ozanakturk/Dolu-Kapasitoru-Ters-Bagla/arduino_codes_050123/farewell_code/LCD connections.jpg

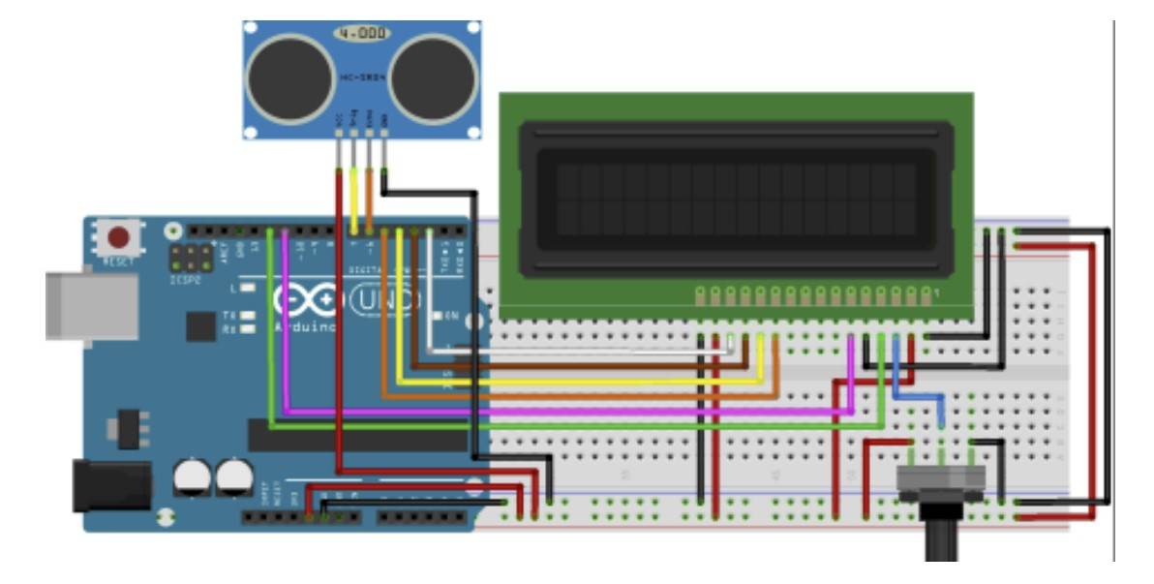
arduino_codes_050123/farewell_code/LCD connections.jpg
