ozanakturk/Dolu-Kapasitoru-Ters-Bagla/README.md

# EE463 Project Github Repo of Dolu Kapasitörü Ters Tut

Ozan Aktürk 2303923

İsa Ersöz 237498

Selin Ezgi Özcan 2375475

Original Project Repo: https://github.com/odtu/ee463/tree/master/Term%20Project
