ozanakturk/Dolu-Kapasitoru-Ters-Bagla/useful links.txt

What is a DC Motor: https://www.youtube.com/watch?v=LAtPHANEfQo

Seperately excited vs. Shunt excited: https://www.youtube.com/watch?v=m2h08euXoDA&list=PLPpCFgQP7QKHUOFYvZhQ6ra5XrU3dN2dD&index=28

Four Quadrant Control with Simulink: https://www.youtube.com/watch?v=LVEipkjerWo

Motor Driver IC info: https://www.youtube.com/watch?v=PVyAcgYkzDs

https://www.youtube.com/watch?v=ygrsIqWOh3Y

https://www.amazon.com/180VDC-motor-controller-output-switch/dp/B0716R6RZQ

https://www.quora.com/How-can-I-convert-220-AC-to-180-DC

https://qr.ae/pvdHLs

Hall sensor 3144  test: https://www.youtube.com/watch?v=pIflB4FQpNE

After presentation:
RPM Counter sensor: https://www.youtube.com/watch?v=XNoN2xGo1F0

Current Sensing with Hall Effect Sensor: https://www.youtube.com/watch?v=p1pQGql65LE
Forget the above link, ACS724 is what you are looking for: https://www.n11.com/urun/acs724-50a-hall-akim-sensor-modulu-14737511?magaza=myrobotech
ACS724 test: https://www.youtube.com/watch?v=ZtrgBSlXcsE

Bootstrap Component Selection Guide by TI: https://www.ti.com/lit/an/slua887/slua887.pdf?ts=1672139985716&ref_url=https%253A%252F%252Fwww.google.com%252F
