ozanakturk/Dolu-Kapasitoru-Ters-Bagla/Final Report/fig/cct.jpg

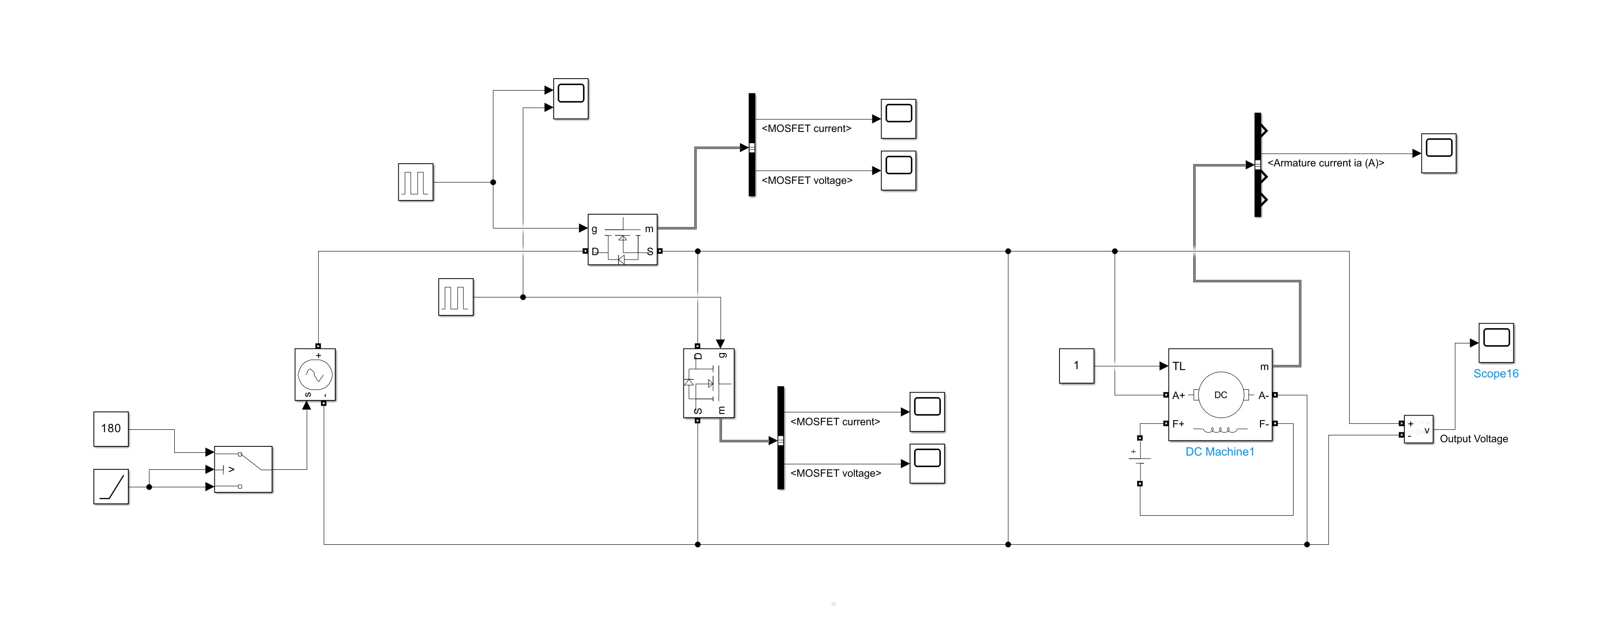
Final Report/fig/cct.jpg
