ozanakturk/Dolu-Kapasitoru-Ters-Bagla/Final Report/fig/diodevolt_rload.jpg

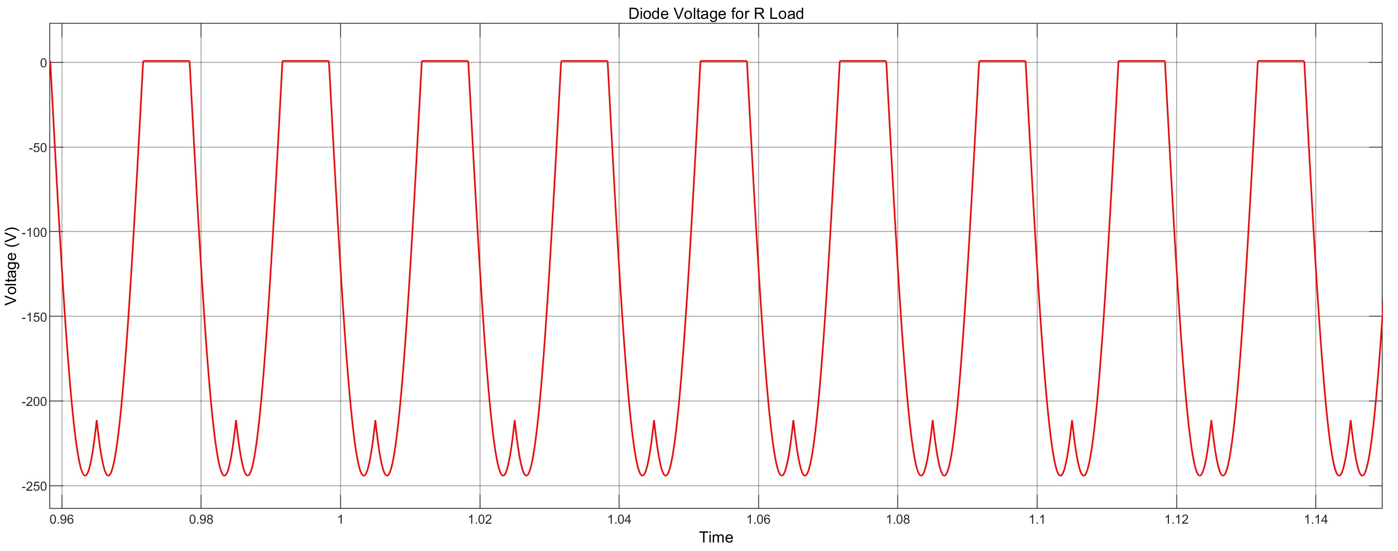
Final Report/fig/diodevolt_rload.jpg
