ozanakturk/Dolu-Kapasitoru-Ters-Bagla/Final Report/fig/diodevoltage.jpg

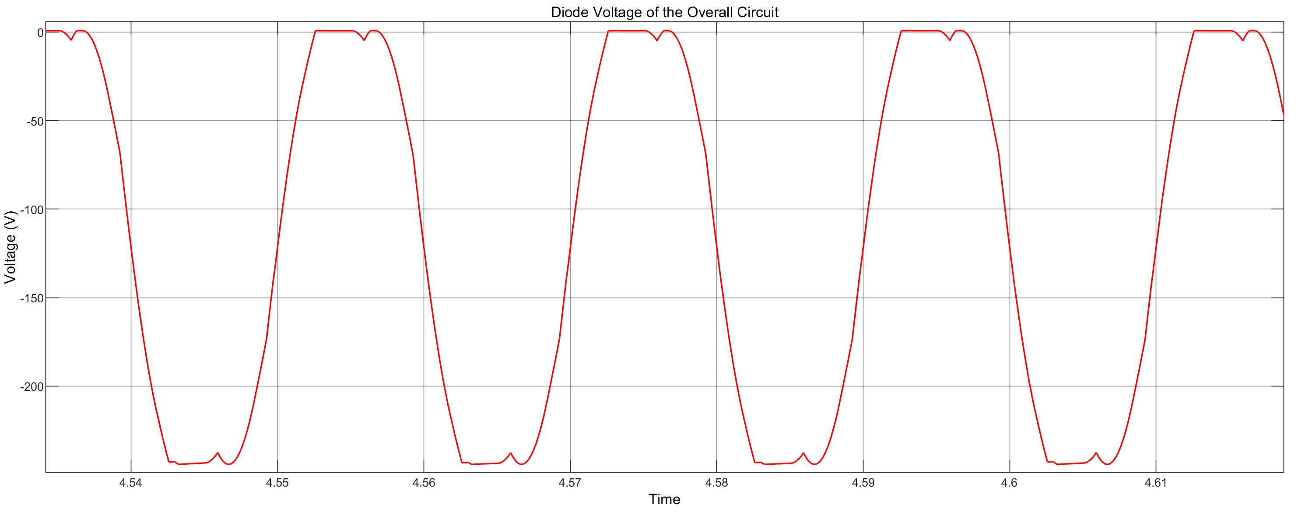
Final Report/fig/diodevoltage.jpg
