ozanakturk/Dolu-Kapasitoru-Ters-Bagla/Final Report/fig/gatesignals.jpg

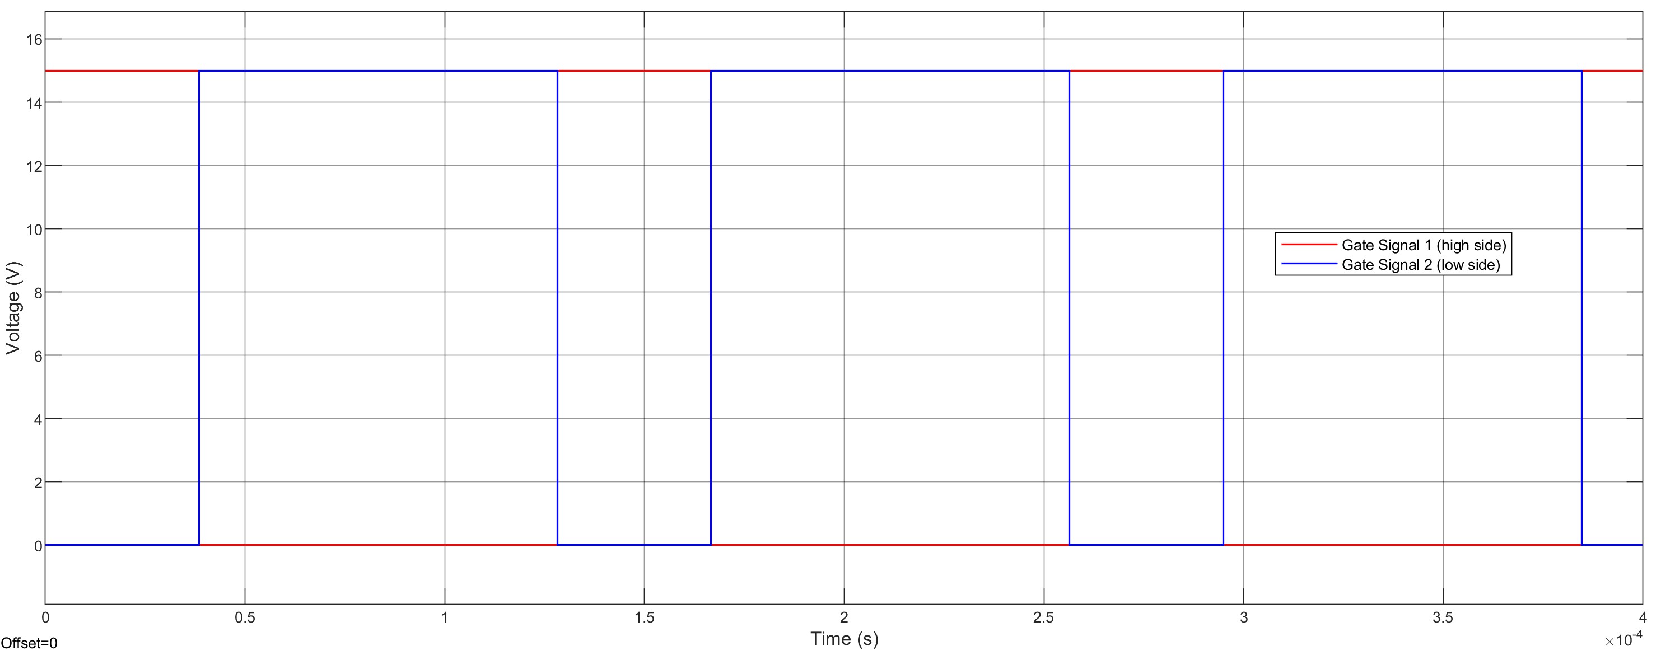
Final Report/fig/gatesignals.jpg
