ozanakturk/Dolu-Kapasitoru-Ters-Bagla/Final Report/fig/hsgate1.jpg

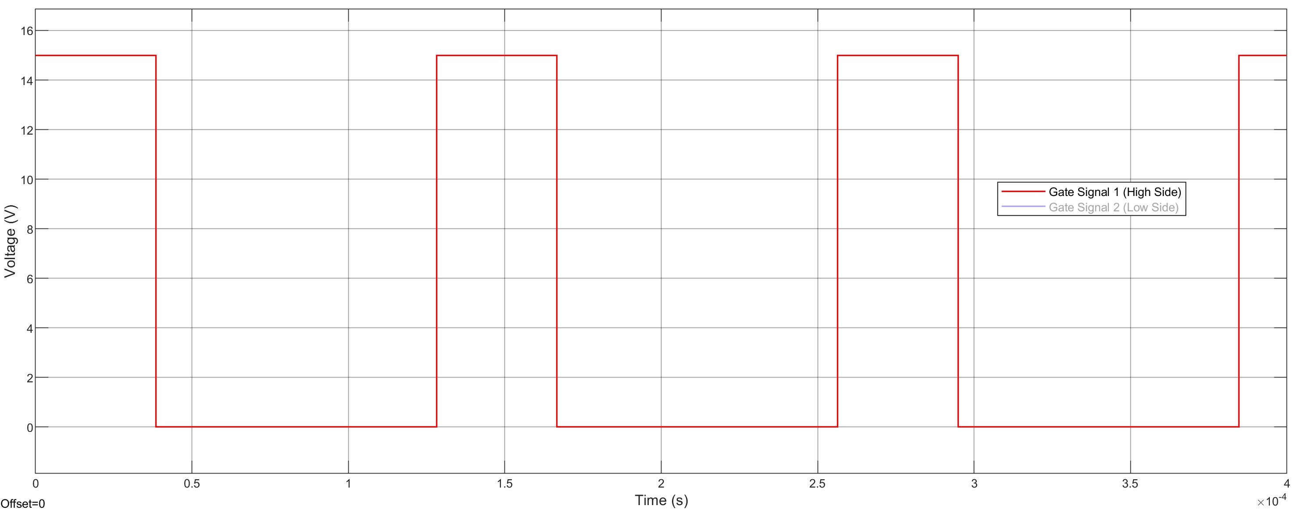
Final Report/fig/hsgate1.jpg
