ozanakturk/Dolu-Kapasitoru-Ters-Bagla/Final Report/fig/lsgate1.jpg

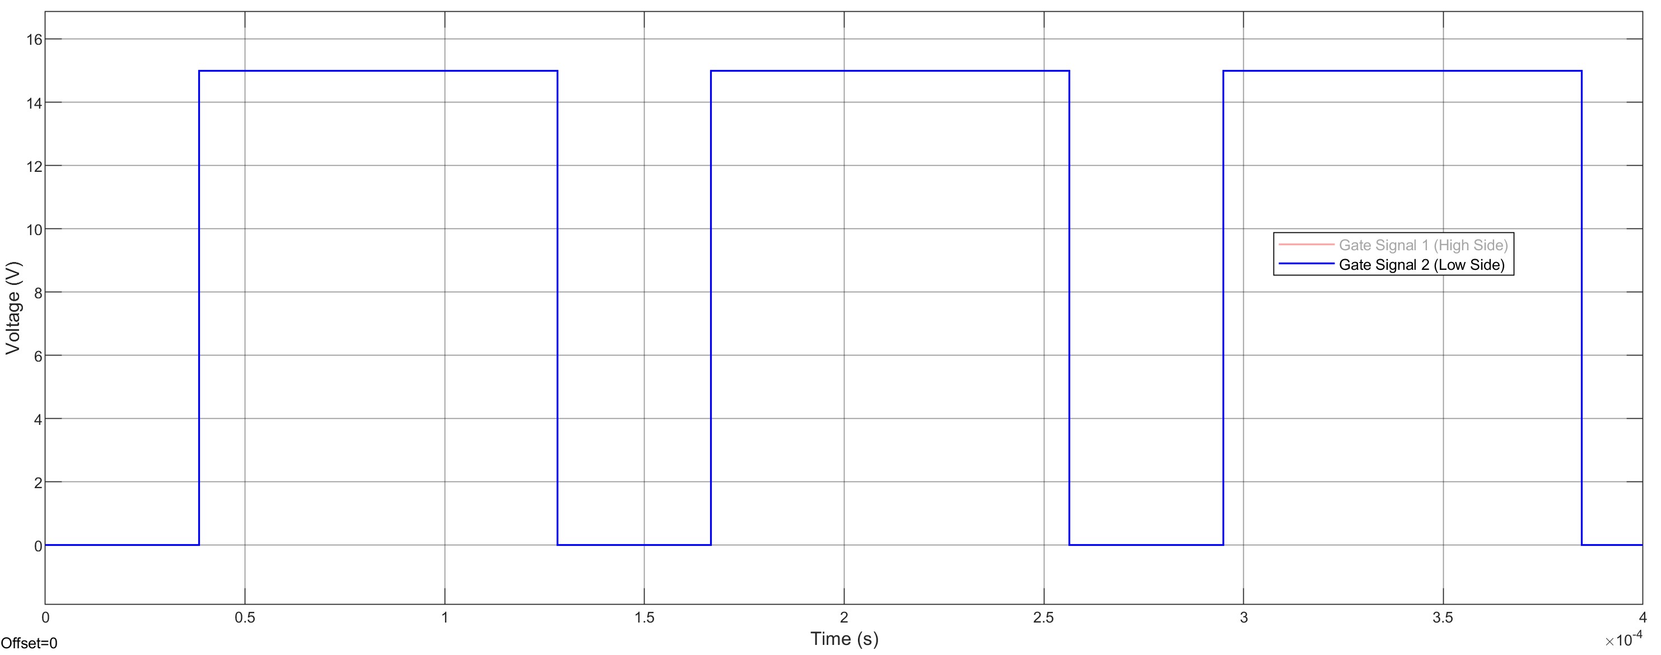
Final Report/fig/lsgate1.jpg
