ozanakturk/Dolu-Kapasitoru-Ters-Bagla/Final Report/fig/rect.jpg

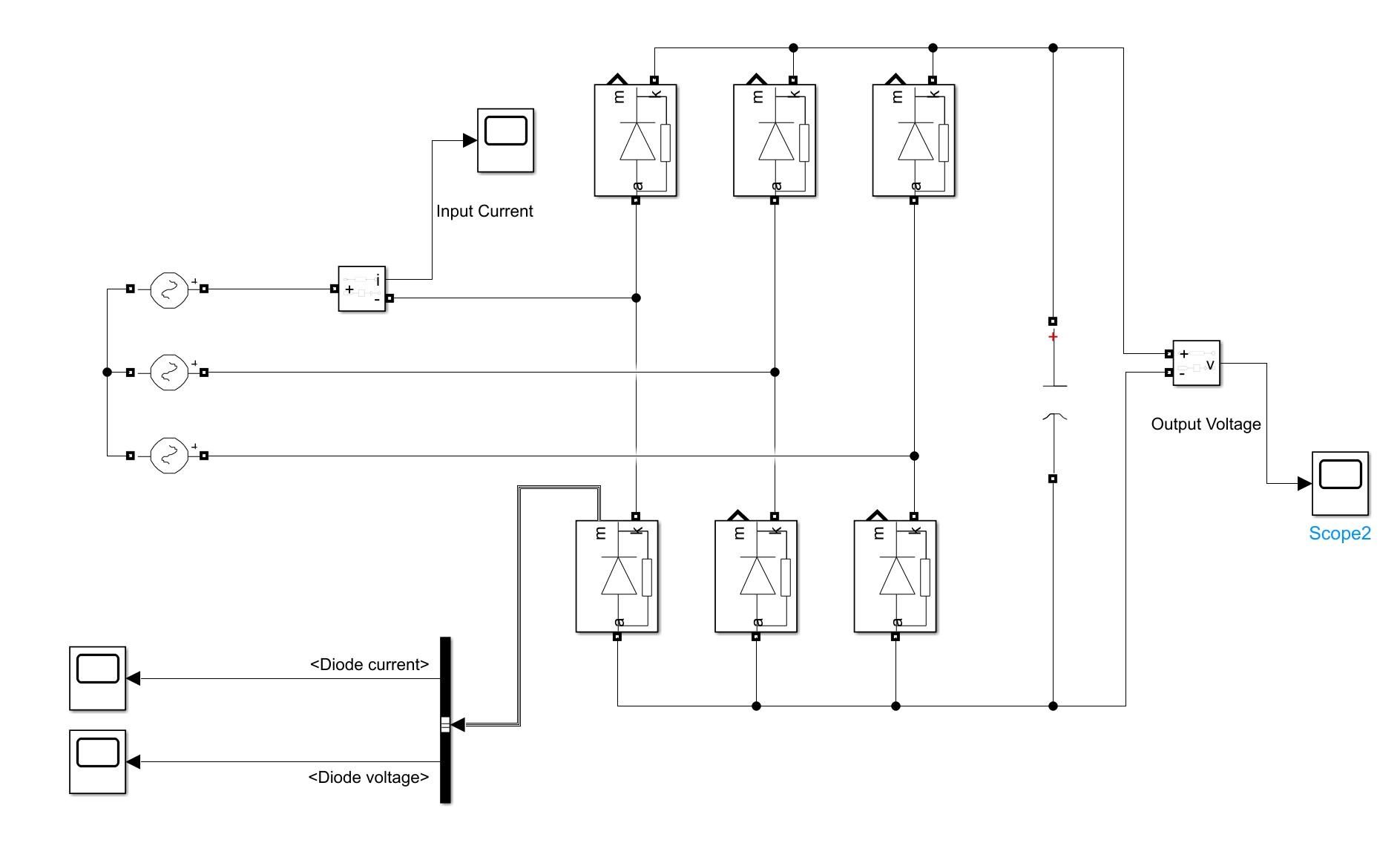
Final Report/fig/rect.jpg
