ozanakturk/Dolu-Kapasitoru-Ters-Bagla/Final Report/fig/rload_rectifier_output.jpg

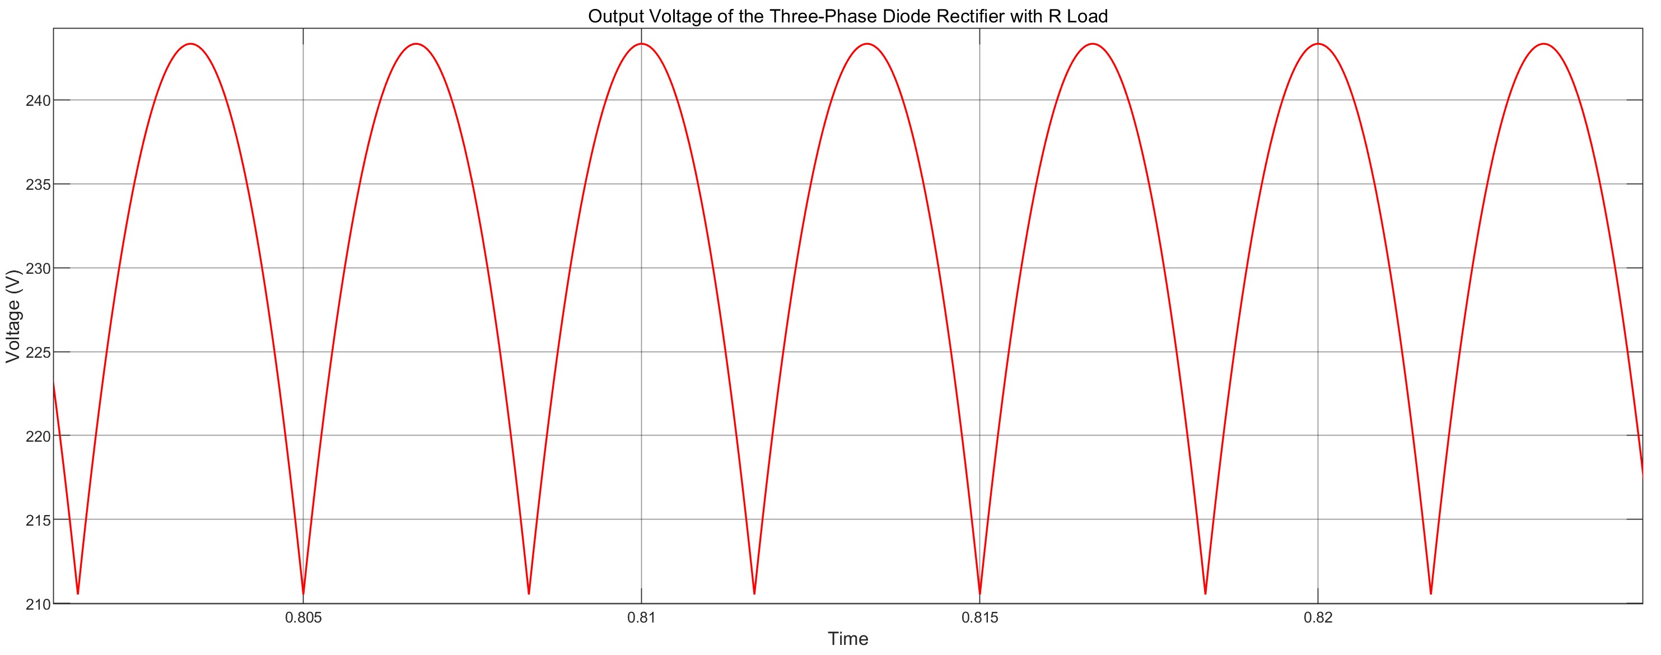
Final Report/fig/rload_rectifier_output.jpg
