ozanakturk/Dolu-Kapasitoru-Ters-Bagla/Final Report/fig/ssdiodecurr.jpg

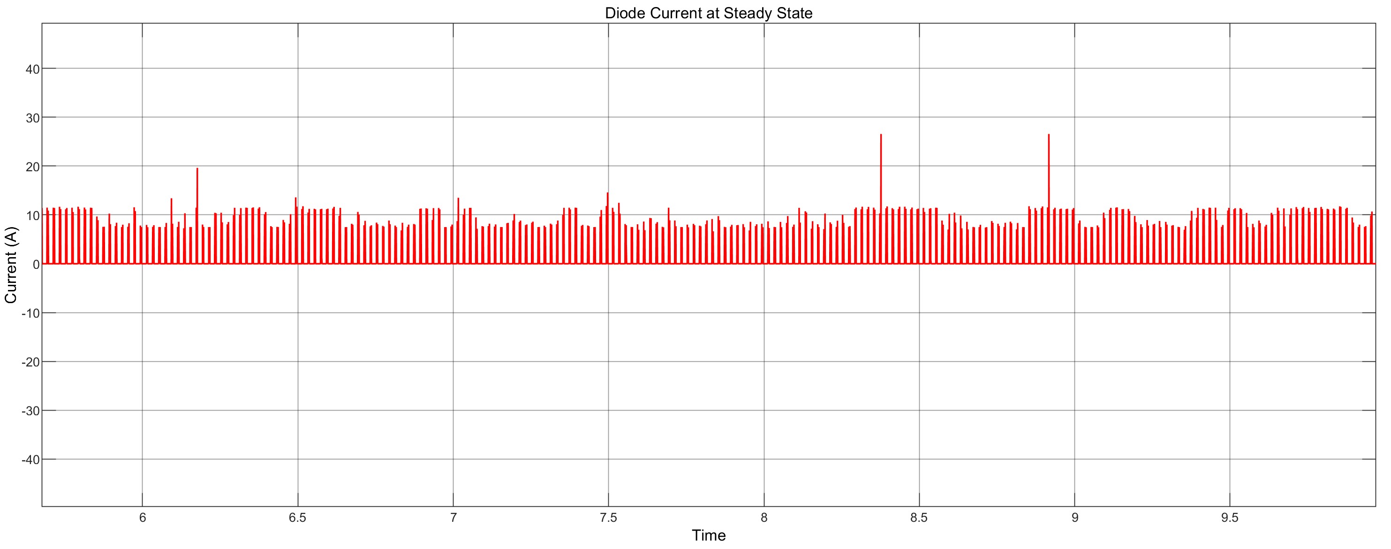
Final Report/fig/ssdiodecurr.jpg
