ozanakturk/Dolu-Kapasitoru-Ters-Bagla/Final Report/fig/ssoutputcurr.jpg

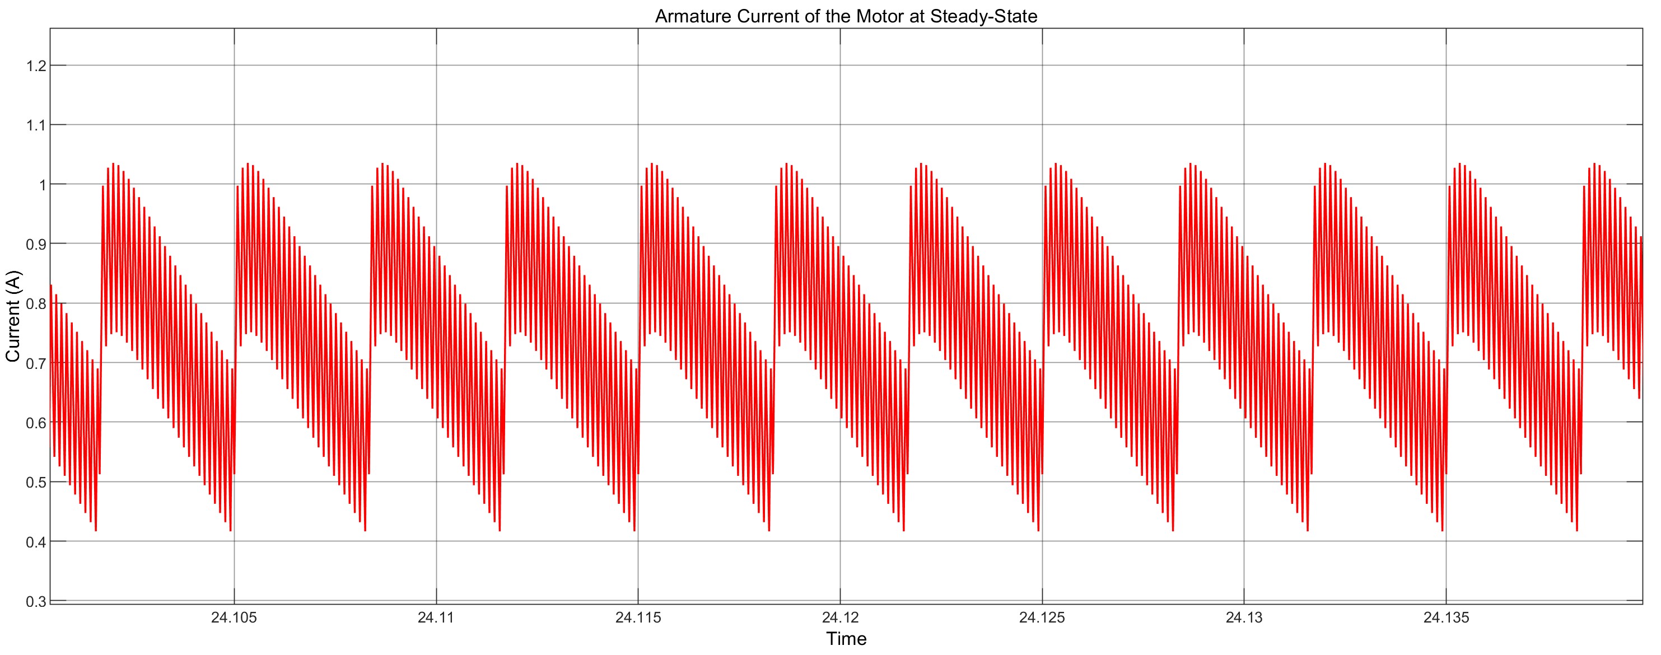
Final Report/fig/ssoutputcurr.jpg
