ozanakturk/Dolu-Kapasitoru-Ters-Bagla/Final Report/fig/ssoutputvolt.jpg

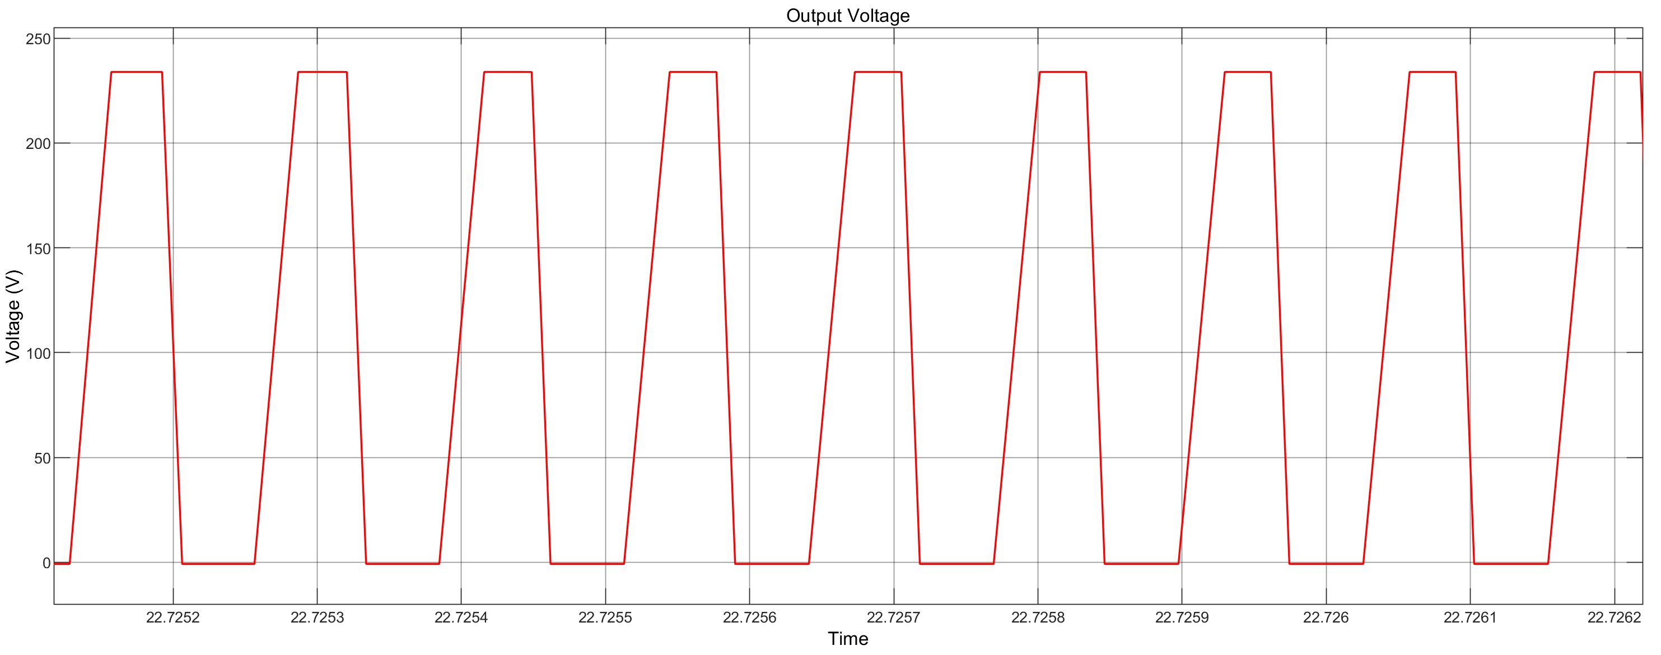
Final Report/fig/ssoutputvolt.jpg
