ozanakturk/Dolu-Kapasitoru-Ters-Bagla/Final Report/fig/together_iout_wo_softstart.jpg

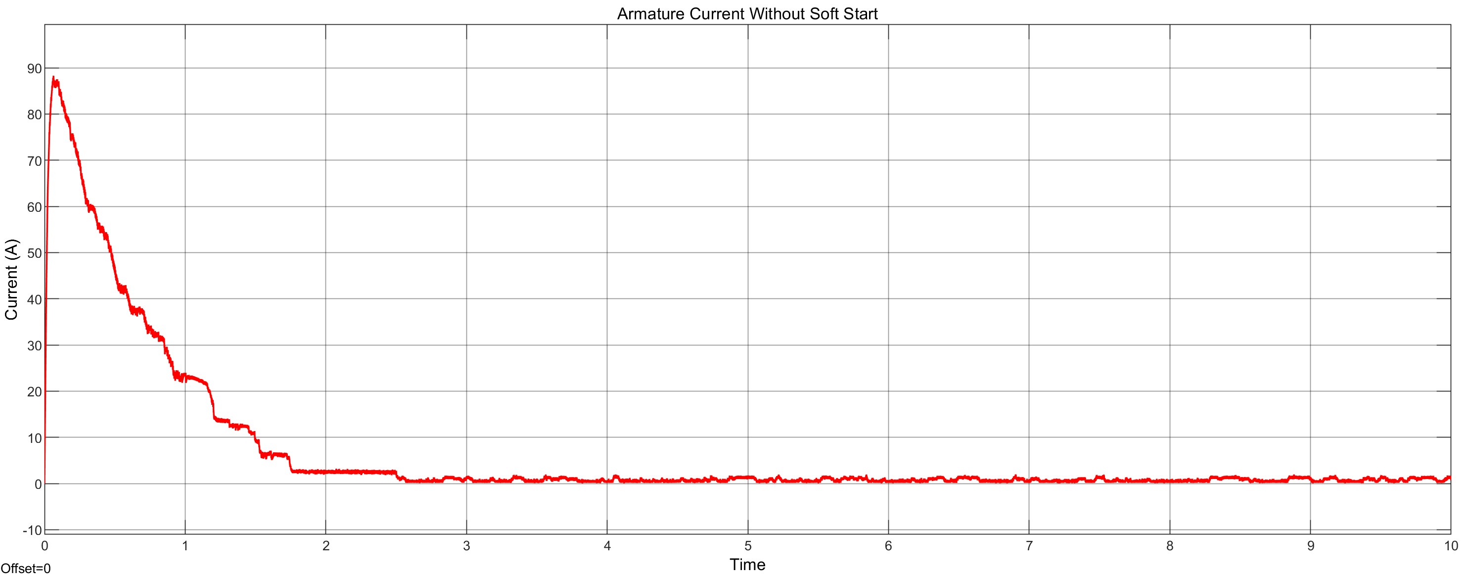
Final Report/fig/together_iout_wo_softstart.jpg
