ozanakturk/Dolu-Kapasitoru-Ters-Bagla/Final Report/fig/vout_together.jpg

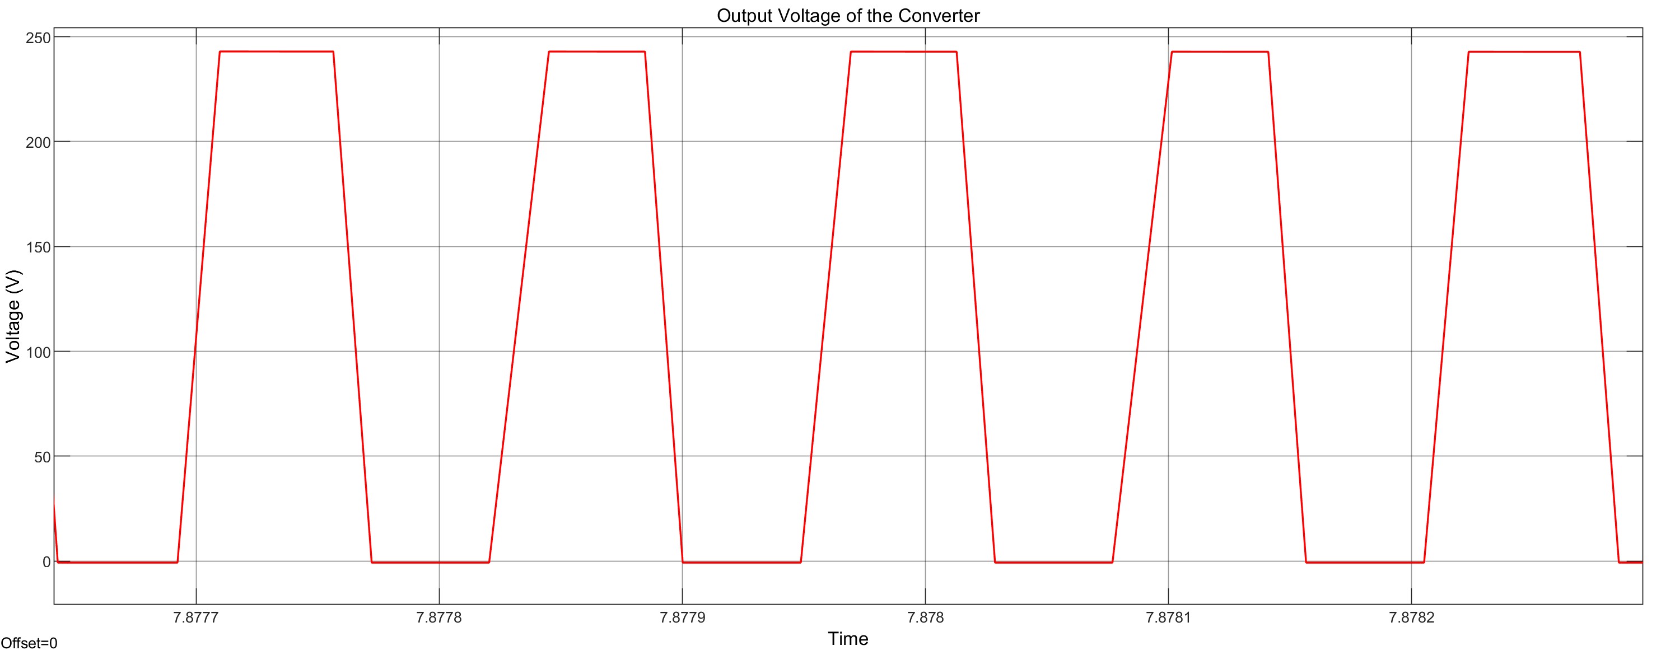
Final Report/fig/vout_together.jpg
