ozanakturk/Dolu-Kapasitoru-Ters-Bagla/flyback.jpg

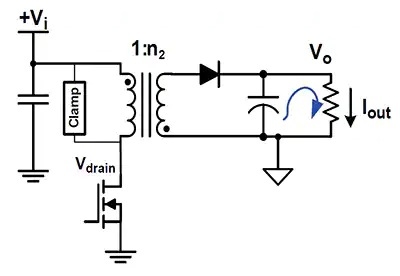
flyback.jpg
