ozanakturk/Dolu-Kapasitoru-Ters-Bagla/IMG_0828.jpeg

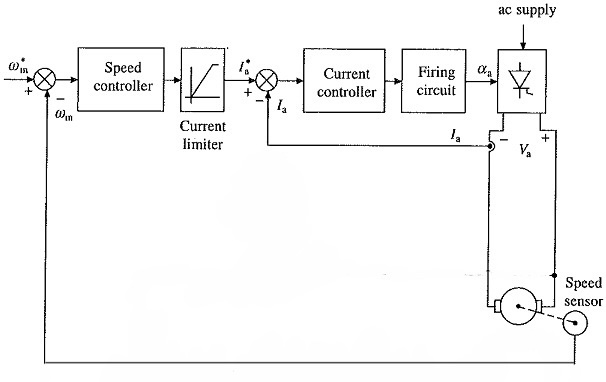
IMG_0828.jpeg
