ozanakturk/Dolu-Kapasitoru-Ters-Bagla/component_list_13_12_22.txt

IXFP36N30P3 MOSFET
ESAD92M-03RRSC DIODE
IR2101STRPBF GATE DRIVER
ACS712 Current Sensor
5x20mm 30A fuse
IR20 infrared 5V sensor
