ozanakturk/Dolu-Kapasitoru-Ters-Bagla/orders/direnc.net.jpg

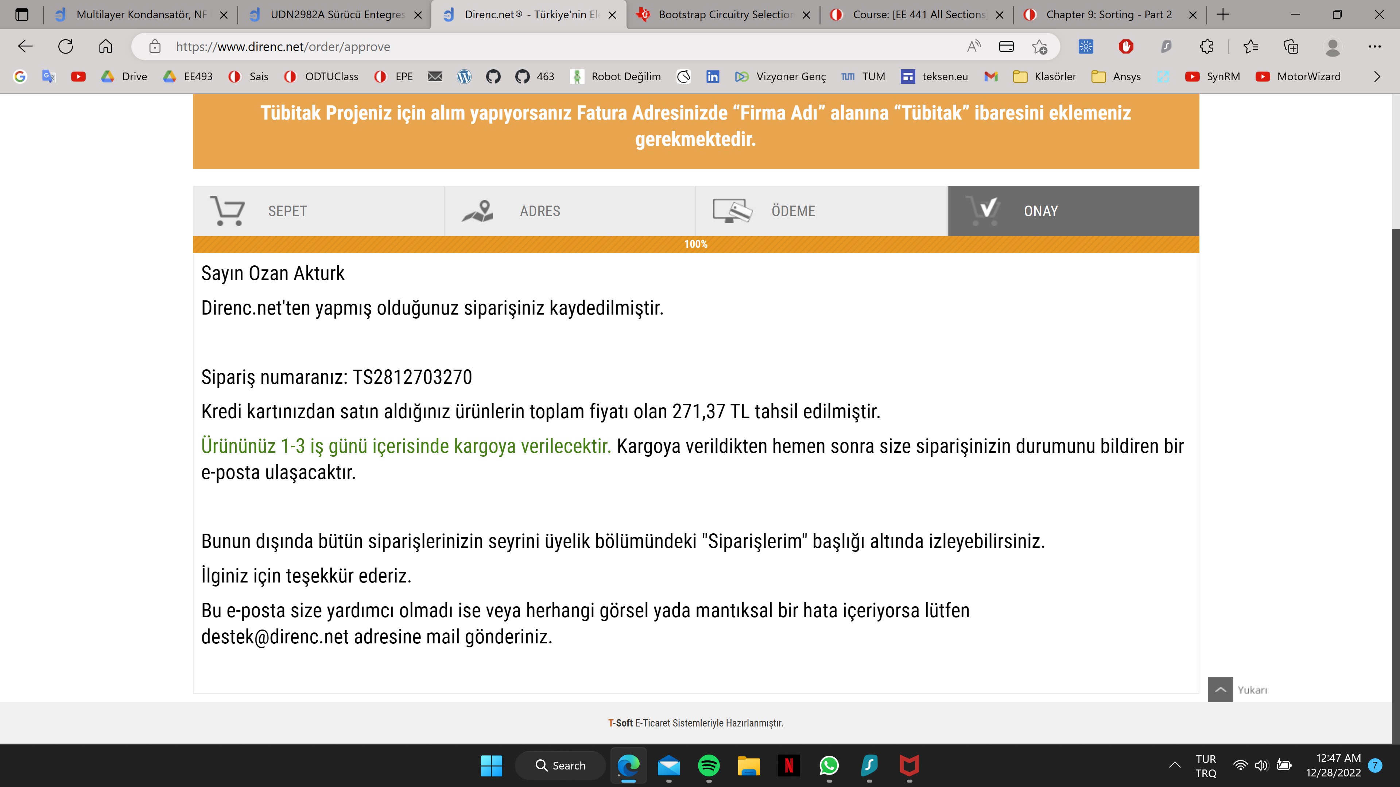
orders/direnc.net.jpg
