ozanakturk/Dolu-Kapasitoru-Ters-Bagla/orders/n11.png

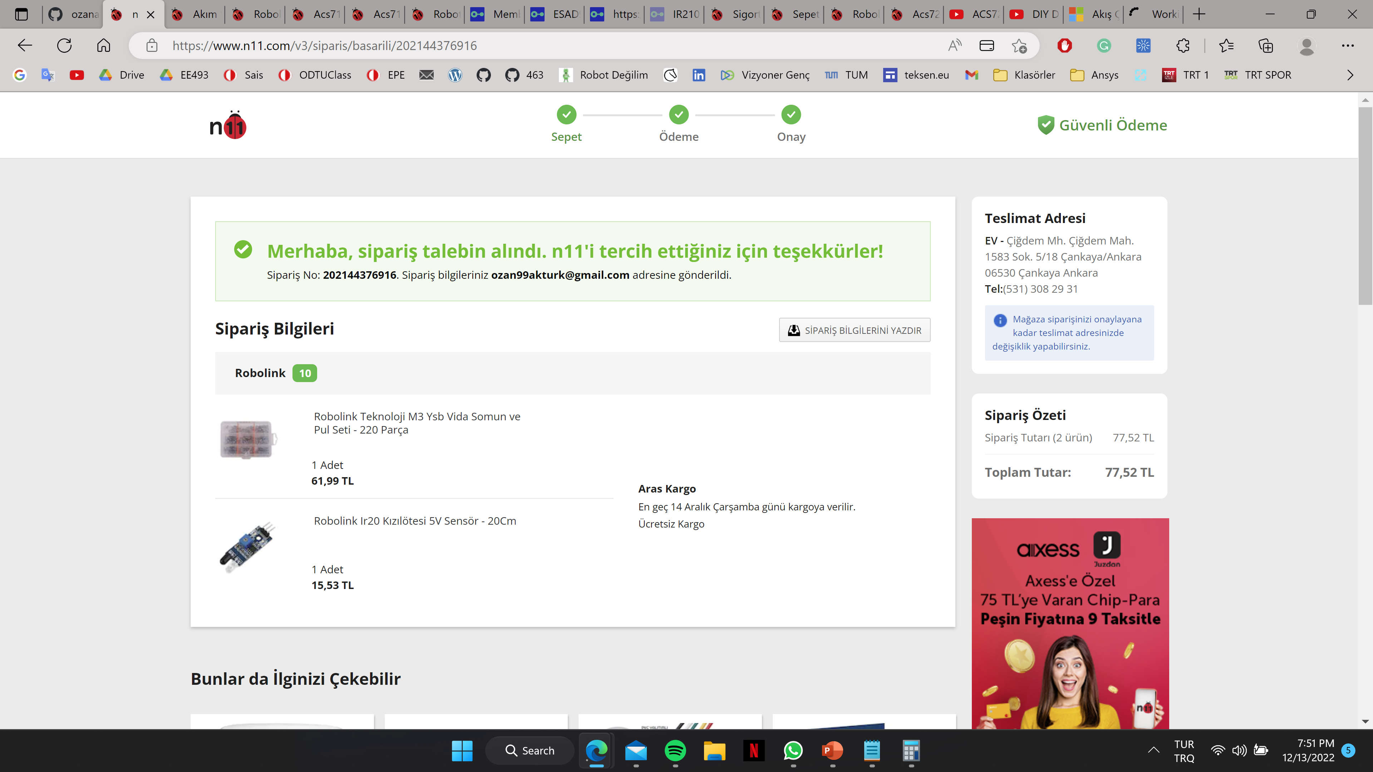
orders/n11.png
