ozanakturk/Dolu-Kapasitoru-Ters-Bagla/orders/robotistan.png

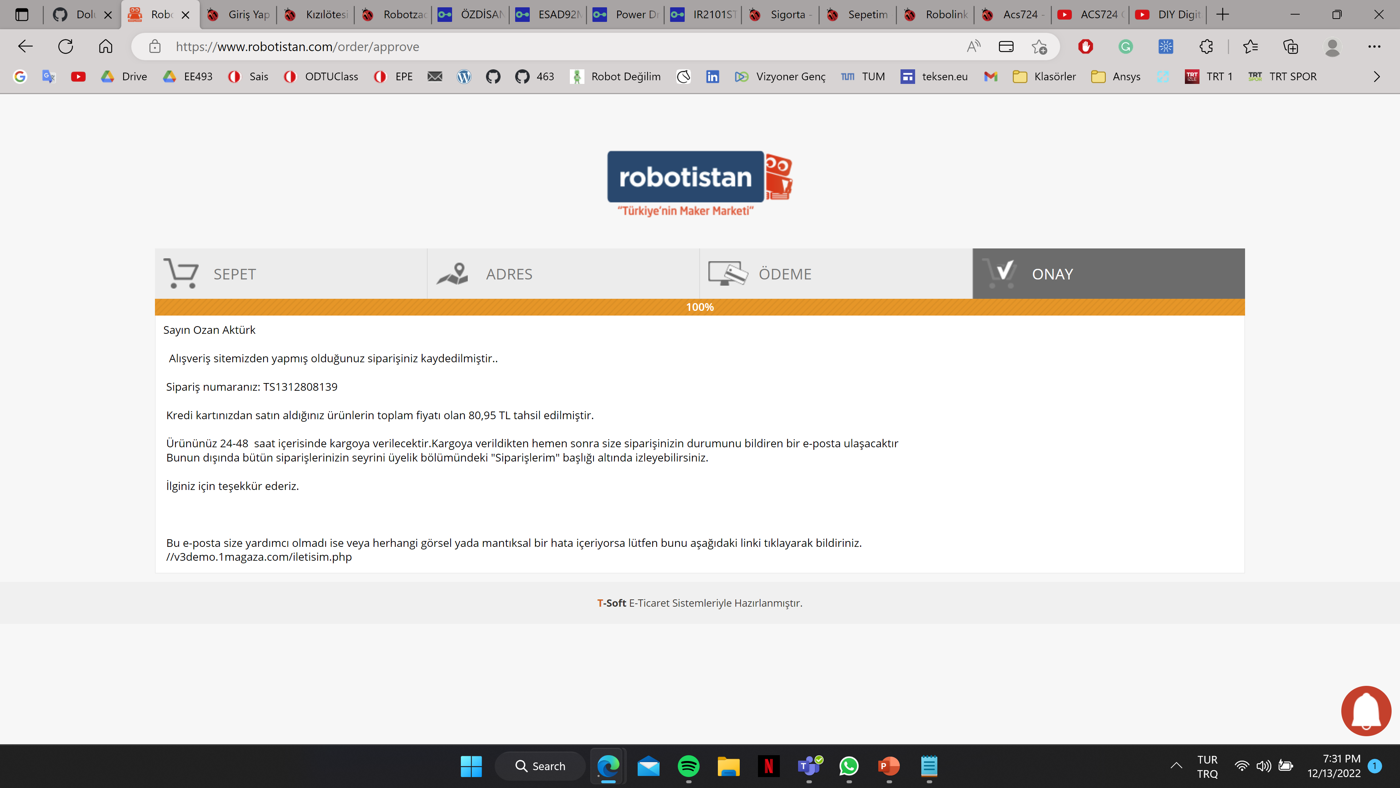
orders/robotistan.png
