ozanakturk/Dolu-Kapasitoru-Ters-Bagla/orders/özdisan.png

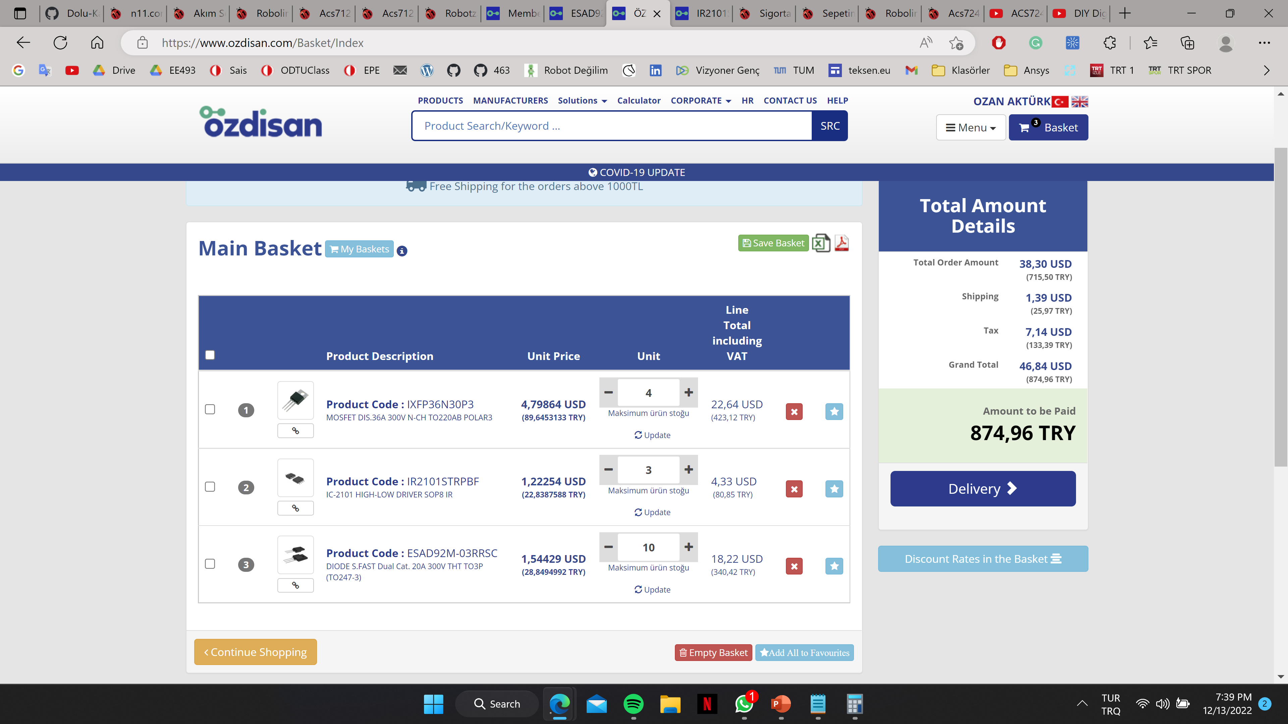
orders/özdisan.png
