ozanakturk/Dolu-Kapasitoru-Ters-Bagla/spicemodel.asc

C1: polcap; 900µ; V=200 Irms=2.08 Rser=0.1485 Lser=16.6573n
D1: diode; RFN60TS6D
D2: diode; RFN60TS6D
D3: diode; RFN60TS6D
D4: diode; RFN60TS6D
D5: diode; RFN60TS6D
D6: diode; RFN60TS6D
L2: ind; 24.5m
M1: nmos; IXTH88N30P
M2: nmos; IXTH88N30P
R1: res; 1.04
V1: voltage; SINE(0 100 50)
V2: voltage; SINE(0 100 50 0 0 120)
V3: voltage; SINE(0 100 50 0 0 240)
V4: voltage; PULSE(0 10 0 5u 5u {(140*x-10)*0.000001} 140u)
V5: voltage; PULSE(0 10 {140*x*0.000001} 5u 5u {(140*(1-x)-10)*0.000001} 140u)
V7: voltage; 0
Named nets: 0
.tran 0 0.15 0
.param x 0.50
