ozanakturk/Dolu-Kapasitoru-Ters-Bagla/MotorDriver.kicad_pcb

## KiCad design MotorDriver.kicad_pcb (2023-01-01)

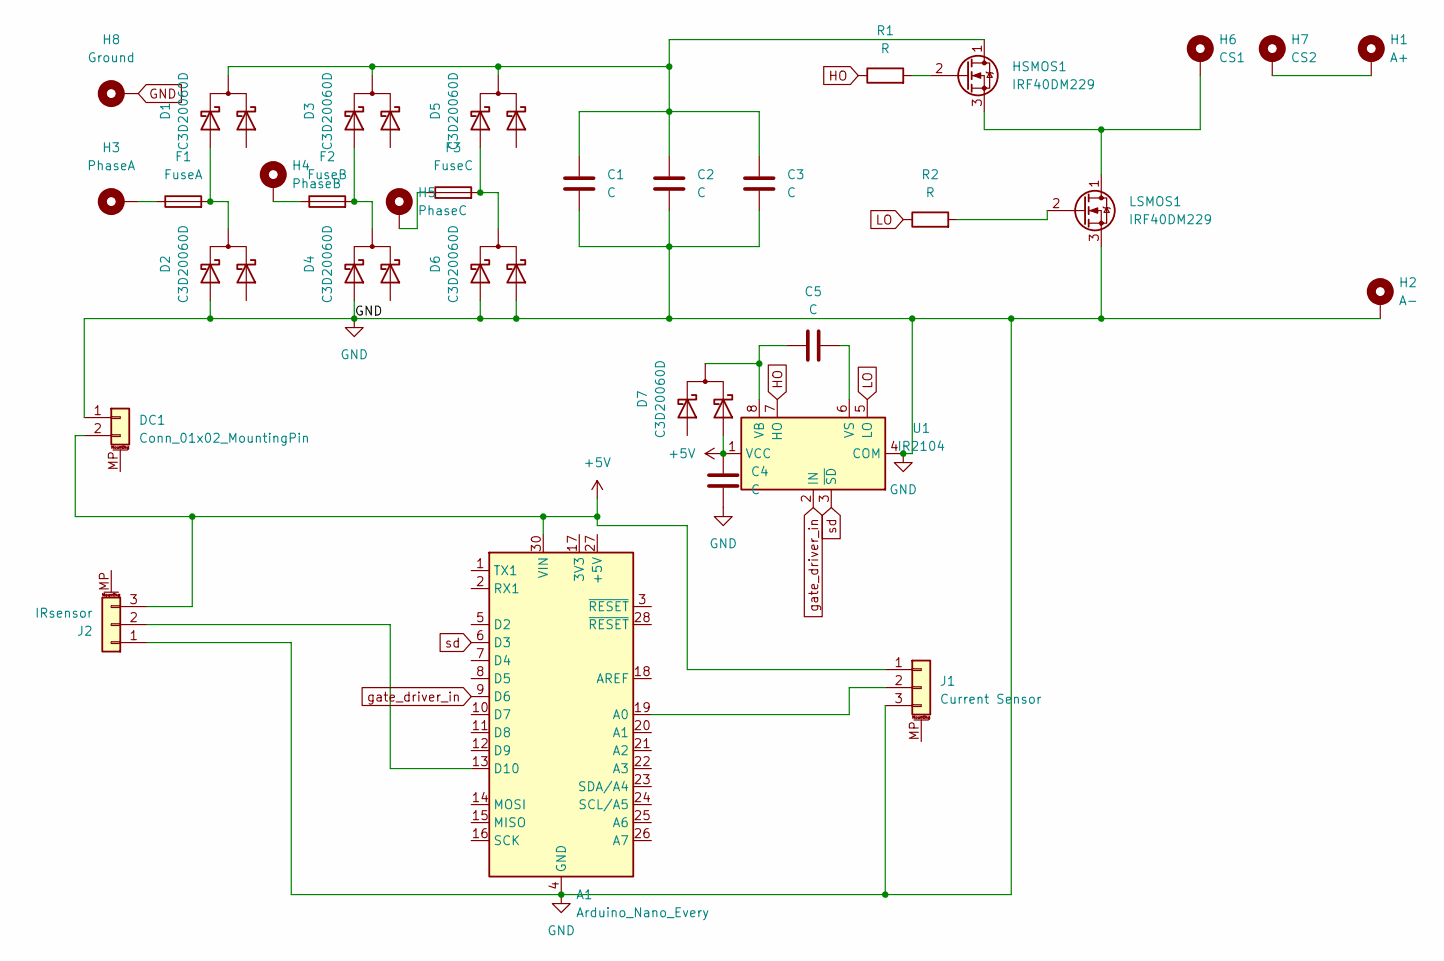
[picture p33: schematic MotorDriver.kicad_sch]

Parts:
A1: Arduino_Nano_Every; Arduino_Nano
C1, C2, C3: C; CP_Axial_L30.0mm_D12.5mm_P35.00mm_Horizontal
C4, C5: C; CP_Axial_L10.0mm_D6.0mm_P15.00mm_Horizontal
D1, D2, D3, D4, D5, D6, D7: C3D20060D; TO-247-3_Vertical
DC1: Conn_01x02_MountingPin; Banana_Jack_2Pin
F1: FuseA; Fuseholder_Cylinder-5x20mm_Schurter_0031_8201_Horizontal_Op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
F2: FuseB; Fuseholder_Cylinder-5x20mm_Schurter_0031_8201_Horizontal_Op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
F3: FuseC; Fuseholder_Cylinder-5x20mm_Schurter_0031_8201_Horizontal_Op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
H1: A+; Banana_Jack_1Pin
H2: A-; Banana_Jack_1Pin
H3: PhaseA; Banana_Jack_1Pin
H4: PhaseB; Banana_Jack_1Pin
H5: PhaseC; Banana_Jack_1Pin
H6: CS1; Banana_Jack_1Pin
H7: CS2; Banana_Jack_1Pin
H8: Ground; Banana_Jack_1Pin
HSMOS1: IRF40DM229; TO-220-3_Vertical
J1: Current Sensor; PinHeader_1x03_P2.54mm_Vertical
J2: IRsensor; PinHeader_1x03_P2.54mm_Vertical
LSMOS1: IRF40DM229; TO-220-3_Vertical
R1, R2: R; R_Axial_DIN0414_L11.9mm_D4.5mm_P5.08mm_Vertical
U1: IR2104; DIP-8_W10.16mm_LongPads

Connections:
+5V: A1.30 (VIN), C4.1, D7.3 (A2), DC1.2, J1.1, J2.3, U1.1 (VCC)
GND: A1.4 (GND), A1.29 (GND), C1.2, C2.2, C3.2, C4.2, D2.1 (A1), D4.1 (A1), D6.1 (A1), D6.3 (A2), DC1.1, H2.1, H8.1, J1.3, J2.1, LSMOS1.3 (S), U1.4 (COM)
HO: R1.1, U1.7 (HO)
LO: R2.1, U1.5 (LO)
unnamed: A1.13 (D10), J2.2
unnamed: A1.19 (A0), J1.2
unnamed: C1.1, C2.1, C3.1, D1.2 (K), D3.2 (K), D5.2 (K), HSMOS1.1 (D)
unnamed: C5.2, U1.6 (VS)
unnamed: D1.1 (A1), D2.2 (K), F1.2
unnamed: D3.1 (A1), D4.2 (K), F2.2
unnamed: D5.1 (A1), D6.2 (K), F3.2
unnamed: C5.1, D7.2 (K), U1.8 (VB)
unnamed: F1.1, H3.1
unnamed: F2.1, H4.1
unnamed: H1.1, H7.1
unnamed: F3.1, H5.1
unnamed: HSMOS1.2 (G), R1.2
unnamed: H6.1, HSMOS1.3 (S), LSMOS1.1 (D)
unnamed: LSMOS1.2 (G), R2.2
gate_driver_in: A1.9 (D6), U1.2 (IN)
sd: A1.6 (D3), U1.3 (~SD)

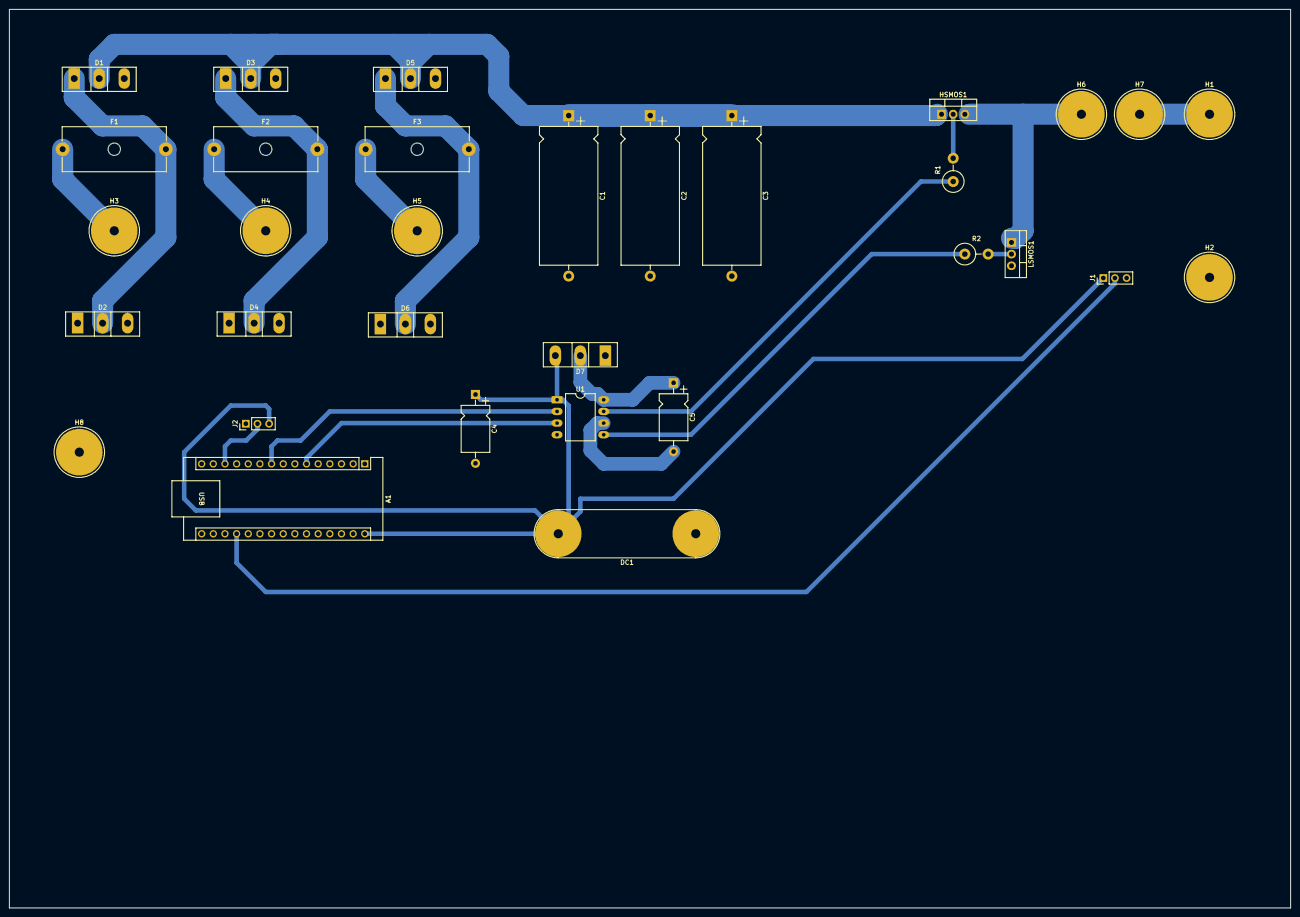
[picture p34: board MotorDriver.kicad_pcb from above]

Board: 2 copper layers, 279.3 x 195.9 mm, 32 parts (0 on the bottom side), 21 nets.
