ozanakturk/Dolu-Kapasitoru-Ters-Bagla/(commit log)

2022-11-21 Edited simulations & added flyback circuit photo
2022-12-06 added two switch forward converter
2022-12-08 simulation with sync buck and dc motor
2022-12-10 Add Hall Sensor video link
2022-12-12 Add current and speed sensor video links
2023-01-01 Board Design - Needs reviewing and editing
    Any comment and criticism are not only welcome but also needed. :)
    [MotorDriver.kicad_pcb, MotorDriver.kicad_sch]
2023-01-04 Current sensor tests on arduino
2023-01-05 Add arduino codes
2023-01-09 added the whole kicad project
2023-01-10 Spice & arduino code changes
2023-01-10 Adjustments on arduino codes
